jgarnierUQ/Homemade-Function-Generator/README.md

# Homemade-Function-Generator
The project that sparked my love of electronics! I made a function generator capable of generating sine, square, triangle, sawtooth, and reverse sawtooth waves up to 10kHz. It was part of a bigger device that also had a filter and power amplifier that all connected to each other.

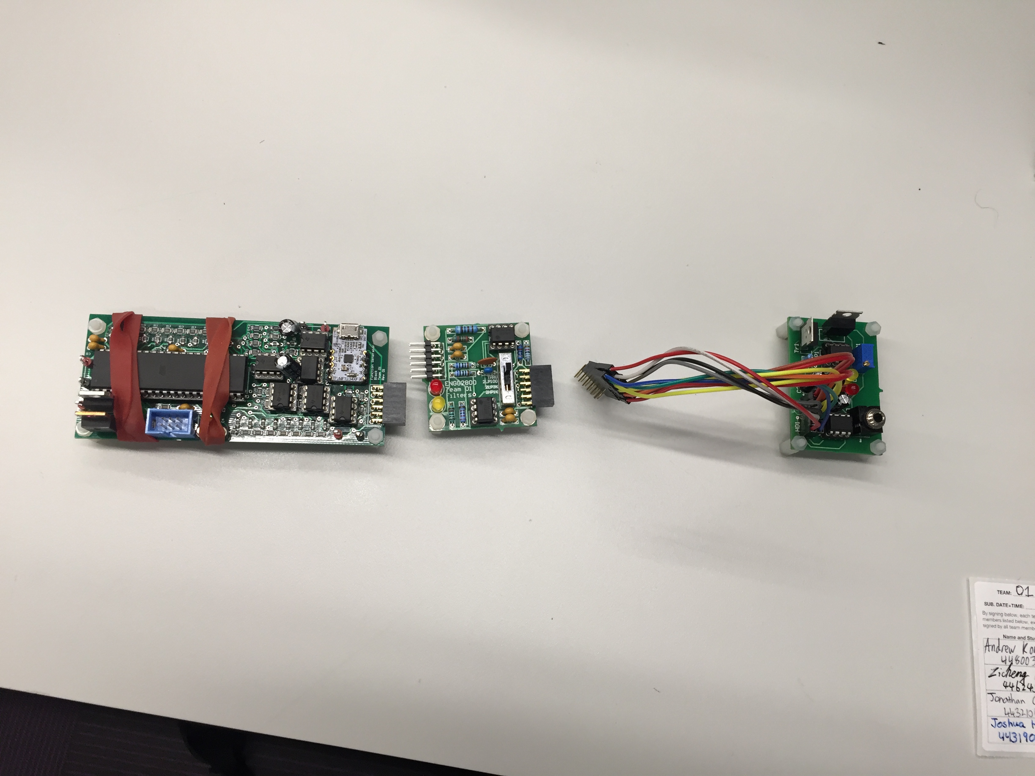
[picture p1: functionGenAllBlocks.JPG]


I was responsible for the function generator block, of which I designed all of the hardware and firmware.
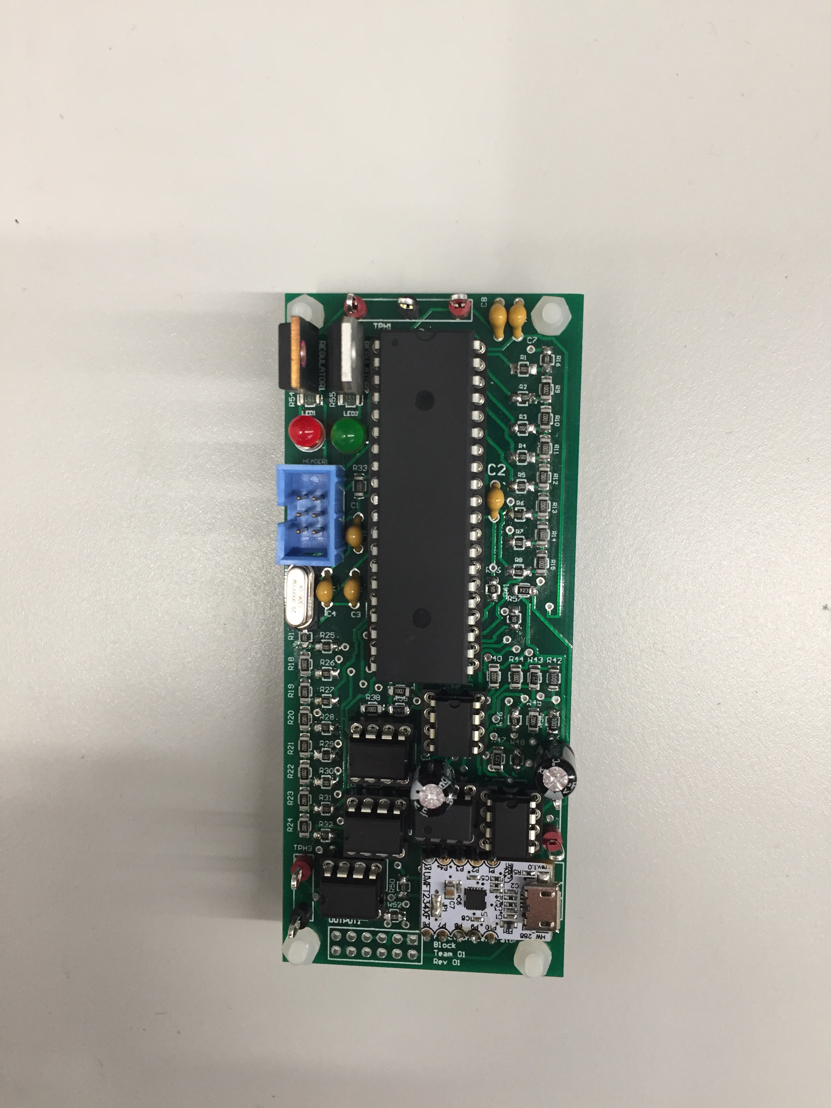
[picture p2: functionGen.JPG]


I utilised an Atmega324 for the processor as we were limited to 8-bit microcontrollers for this project. I was able to output the required waveforms by creating my own Digital to Analog Converters using resistor ladders, and then using look-up tables in firmware to control the waveforms.

This project was quite challenging but extremely rewarding once it was a working product. By far the most challenging aspect was the firmware, specifically being able to change the frequency of the waves. For this I implemented a phase accumulator (https://en.wikipedia.org/wiki/Numerically-controlled_oscillator), which caused a lot of headaches but got the job done! All of the code is available to view as well as my hardware schematics and Altium layouts.
