jgarnierUQ/Homemade-Function-Generator/Hardware/Function Generator Schematic.pdf

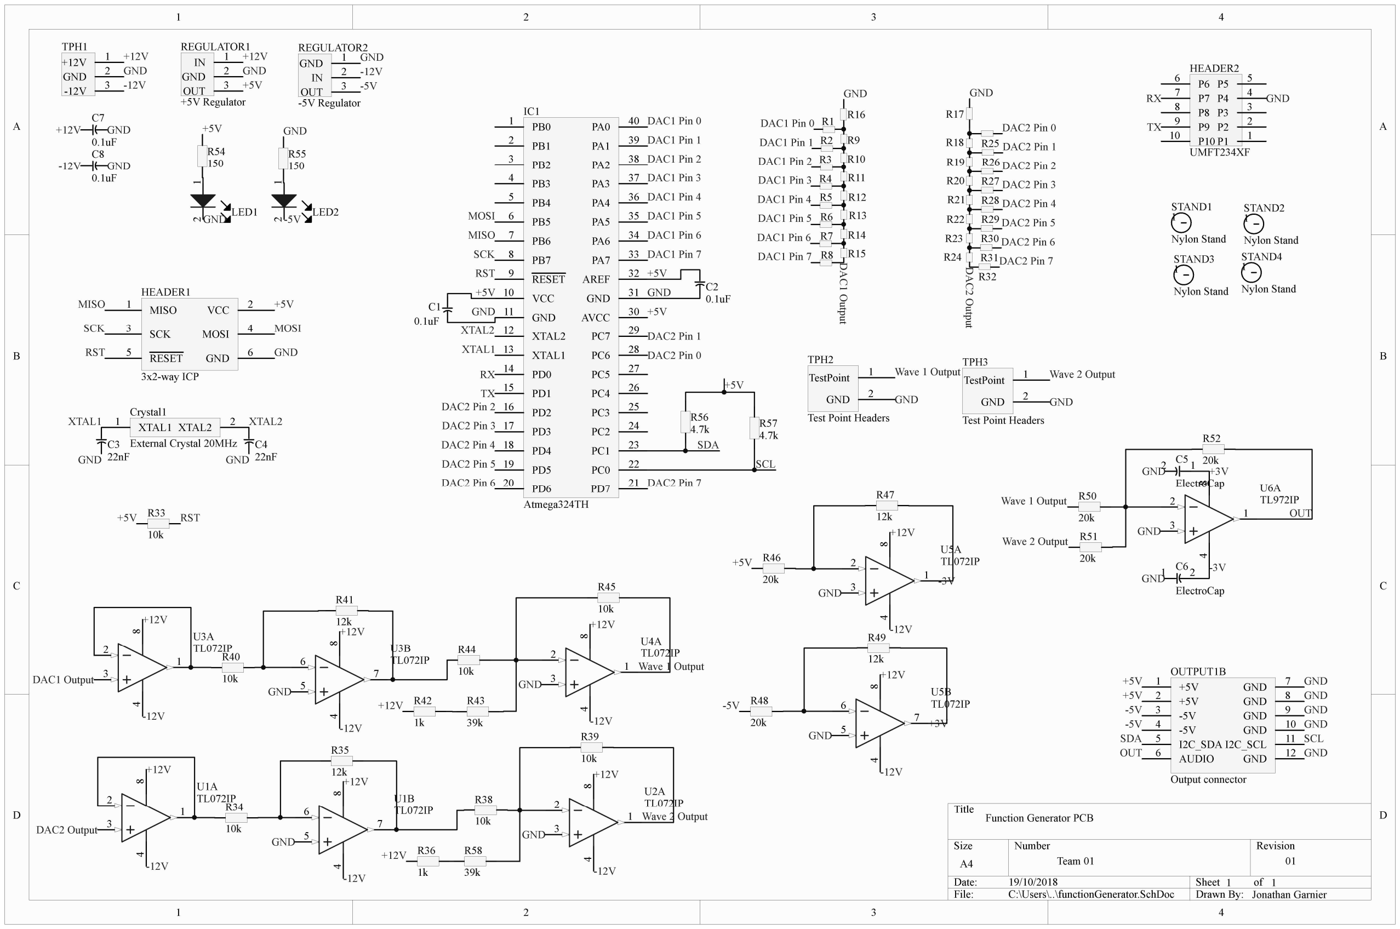
[picture p3: page 1]

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
Title

Size | Number | | Revision
A4
Date: | 19/10/2018 | Sheet | of
File: | C:\Users\..\functionGenerator.SchDoc | Drawn By:
+12V | 1
GND | 2
-12V | 3

TPH1
IN | 1
GND | 2
OUT | 3

REGULATOR1

+5V Regulator

GND | GND

PB0 1
PB1 2
PB2 3
PB3 4
PB4 5
PB5 6
PB6 7
PB7 8
RESET 9
VCC 10
GND 11
XTAL2 12
XTAL1 13
PD0 14
PD1 15
PD2 16
PD3 17
PD4 18
PD5 19
PD6 20 | PD7 | 21
| PC0 | 22
PC1 | 23
PC2 | 24
PC3 | 25
PC4 | 26
PC5 | 27
PC6 | 28
PC7 | 29
AVCC | 30
GND | 31
AREF | 32
PA7 | 33
PA6 | 34
PA5 | 35
PA4 | 36
PA3 | 37
PA2 | 38
PA1 | 39
PA0 | 40

IC1

Atmega324TH

+5V

+5V

+5V

+5V

GND
GND C1
0.1uF

C2
0.1uF

Function Generator PCB

Team 01 | 01
| Jonathan Garnier

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
DAC2 Pin 0
DAC2 Pin 1
DAC2 Pin 2
DAC2 Pin 3
DAC2 Pin 4
DAC2 Pin 5
DAC2 Pin 6
DAC2 Pin 7

DAC2 Pin 2
DAC2 Pin 3
DAC2 Pin 4
DAC2 Pin 5
DAC2 Pin 6 | DAC2 Pin 7

DAC1 Pin 0
DAC1 Pin 1
DAC1 Pin 2
DAC1 Pin 3
DAC1 Pin 4
DAC1 Pin 5
DAC1 Pin 6
DAC1 Pin 7

DAC1 Pin 0
DAC1 Pin 1
DAC1 Pin 2
DAC1 Pin 3
DAC1 Pin 4
DAC1 Pin 5
DAC1 Pin 6
DAC1 Pin 7

XTAL2 2 XTAL1 1

Crystal1

External Crystal 20MHz

XTAL1 | XTAL2

XTAL1

XTAL2

C3
22nF

C4
GND | GND 22nF

SCK

MISO

MOSI

RST

MISO 1 | VCC | 2
SCK 3 | MOSI | 4
RESET 5 | GND | 6

HEADER1

3x2-way ICP

+5V

GND

MOSI

MISO

SCK

RST

AUDIO 6

I2C_SDA 5

-5V 4

-5V 3

+5V 2

+5V 1 | GND | 7
| GND | 8
| GND | 9
| GND | 10
| I2C_SCL | 11
| GND | 12

OUTPUT1B

Output connector

+5V
+5V
GND | 1
IN | 2
OUT | 3

REGULATOR2

-5V Regulator

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
7 4 8 | U1B

### 1 TL072IP

2

3 | 4 8 | U1A TL072IP
+12V | +12V

-12V

-12V

-12V
-12V

+12V
+12V

GND

1

2

3 | 4 8 | U2A TL072IP

GND

+12V

-12V

R34

10k

R38

10k

R39

10k | DAC2 Output DAC1 Output

5

6

7 4 8 | U3B

### 1 TL072IP

2

3 | 4 8 | U3A TL072IP

-12V
-12V

+12V
+12V

GND

1

2

3 | 4 8 | U4A TL072IP

GND

+12V

-12V

R40

10k

R44

10k

R45

10k

DAC1 Output

DAC2 Output

1

2

3 | 4 8 | U6A TL972IP

1

2

3 | 4 8 | U5A TL072IP

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
+12V

-12V

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
7 4 8 | U5B
TL072IP

+12V

-12V

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
ElectroCap

1 2 C6

ElectroCap

GND

GND

C7

0.1uF
C8

0.1uF

GND

GND

+12V

-12V

R33

10k

P1 | 1
P2 | 2
P3 | 3
P4 | 4
P5 | 5 P6 6
P7 7
P8 8
P9 9
P10 10

HEADER2

UMFT234XF

GND

RX
TX

RX

TX

1

STAND1

Nylon Stand

1

STAND2

Nylon Stand

1

STAND3

Nylon Stand

1

STAND4

Nylon Stand

TestPoint | 1
GND | 2

TPH2

Test Point Headers

TestPoint | 1
GND | 2

TPH3

Test Point Headers

GND | GND

DAC2 Pin 1
DAC2 Pin 0

1 2

LED1 1 2

LED2 GND | -5V
SDA | SCL
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
4.7k | R57
| 4.7k

Wave 1 Output

Wave 2 Output

Wave 1 Output | Wave 2 Output
+5V | GND

RST

+12V

+12V

-5V

+5V

+5V

Wave 1 Output

Wave 2 Output
