jgarnierUQ/Homemade-Function-Generator/Hardware/BOM.xlsx

Designator | Component type | Value | Other notes | Quantity | Minimum order quantity | Cost each ($AUD) | Total price | Digikey # | Mouser # | RS # | E14 # | ETSG # | RoHS? | Datasheet URL
FUNCTION GENERATOR
R1 | Resistor, Surface Mount | 20k, 1% | 805 | 1 | 1 | 0.02 | 0.02 |  |  |  |  | 61-07-09 | Yes (See Distributer) | N/A
R2 | Resistor, Surface Mount | 20k, 1% | 805 | 1 | 1 | 0.02 | 0.02 |  |  |  |  | 61-07-10 | Yes (See Distributer) | N/A
R3 | Resistor, Surface Mount | 20k, 1% | 805 | 1 | 1 | 0.02 | 0.02 |  |  |  |  | 61-07-11 | Yes (See Distributer) | N/A
R4 | Resistor, Surface Mount | 20k, 1% | 805 | 1 | 1 | 0.02 | 0.02 |  |  |  |  | 61-07-12 | Yes (See Distributer) | N/A
R5 | Resistor, Surface Mount | 20k, 1% | 805 | 1 | 1 | 0.02 | 0.02 |  |  |  |  | 61-07-13 | Yes (See Distributer) | N/A
R6 | Resistor, Surface Mount | 20k, 1% | 805 | 1 | 1 | 0.02 | 0.02 |  |  |  |  | 61-07-14 | Yes (See Distributer) | N/A
R7 | Resistor, Surface Mount | 20k, 1% | 805 | 1 | 1 | 0.02 | 0.02 |  |  |  |  | 61-07-15 | Yes (See Distributer) | N/A
R8 | Resistor, Surface Mount | 20k, 1% | 805 | 1 | 1 | 0.02 | 0.02 |  |  |  |  | 61-07-16 | Yes (See Distributer) | N/A
R9 | Resistor, Surface Mount | 10k, 1% | 1206 | 1 | 1 | 0.01 | 0.01 |  |  |  |  | 63-04-05 | Yes (See Distributer) | N/A
R10 | Resistor, Surface Mount | 10k, 1% | 1206 | 1 | 1 | 0.01 | 0.01 |  |  |  |  | 63-04-06 | Yes (See Distributer) | N/A
R11 | Resistor, Surface Mount | 10k, 1% | 1206 | 1 | 1 | 0.01 | 0.01 |  |  |  |  | 63-04-07 | Yes (See Distributer) | N/A
R12 | Resistor, Surface Mount | 10k, 1% | 1206 | 1 | 1 | 0.01 | 0.01 |  |  |  |  | 63-04-08 | Yes (See Distributer) | N/A
R13 | Resistor, Surface Mount | 10k, 1% | 1206 | 1 | 1 | 0.01 | 0.01 |  |  |  |  | 63-04-09 | Yes (See Distributer) | N/A
R14 | Resistor, Surface Mount | 10k, 1% | 1206 | 1 | 1 | 0.01 | 0.01 |  |  |  |  | 63-04-10 | Yes (See Distributer) | N/A
R15 | Resistor, Surface Mount | 10k, 1% | 1206 | 1 | 1 | 0.01 | 0.01 |  |  |  |  | 63-04-11 | Yes (See Distributer) | N/A
R16 | Resistor, Surface Mount | 20k, 1% | 805 | 1 | 1 | 0.02 | 0.02 |  |  |  |  | 61-07-16 | Yes (See Distributer) | N/A
R17 | Resistor, Surface Mount | 20k, 1% | 805 | 1 | 1 | 0.02 | 0.02 |  |  |  |  | 61-07-17 | Yes (See Distributer) | N/A
R18 | Resistor, Surface Mount | 10k, 1% | 1206 | 1 | 1 | 0.01 | 0.01 |  |  |  |  | 63-04-11 | Yes (See Distributer) | N/A
R19 | Resistor, Surface Mount | 10k, 1% | 1206 | 1 | 1 | 0.01 | 0.01 |  |  |  |  | 63-04-12 | Yes (See Distributer) | N/A
R20 | Resistor, Surface Mount | 10k, 1% | 1206 | 1 | 1 | 0.01 | 0.01 |  |  |  |  | 63-04-13 | Yes (See Distributer) | N/A
R21 | Resistor, Surface Mount | 10k, 1% | 1206 | 1 | 1 | 0.01 | 0.01 |  |  |  |  | 63-04-14 | Yes (See Distributer) | N/A
R22 | Resistor, Surface Mount | 10k, 1% | 1206 | 1 | 1 | 0.01 | 0.01 |  |  |  |  | 63-04-15 | Yes (See Distributer) | N/A
R23 | Resistor, Surface Mount | 10k, 1% | 1206 | 1 | 1 | 0.01 | 0.01 |  |  |  |  | 63-04-16 | Yes (See Distributer) | N/A
R24 | Resistor, Surface Mount | 10k, 1% | 1206 | 1 | 1 | 0.01 | 0.01 |  |  |  |  | 63-04-17 | Yes (See Distributer) | N/A
R25 | Resistor, Surface Mount | 20k, 1% | 805 | 1 | 1 | 0.02 | 0.02 |  |  |  |  | 61-07-16 | Yes (See Distributer) | N/A
R26 | Resistor, Surface Mount | 20k, 1% | 805 | 1 | 1 | 0.02 | 0.02 |  |  |  |  | 61-07-17 | Yes (See Distributer) | N/A
R27 | Resistor, Surface Mount | 20k, 1% | 805 | 1 | 1 | 0.02 | 0.02 |  |  |  |  | 63-04-17 | Yes (See Distributer) | N/A
R28 | Resistor, Surface Mount | 20k, 1% | 805 | 1 | 1 | 0.02 | 0.02 |  |  |  |  | 63-04-18 | Yes (See Distributer) | N/A
R29 | Resistor, Surface Mount | 20k, 1% | 805 | 1 | 1 | 0.02 | 0.02 |  |  |  |  | 63-04-19 | Yes (See Distributer) | N/A
R30 | Resistor, Surface Mount | 20k, 1% | 805 | 1 | 1 | 0.02 | 0.02 |  |  |  |  | 63-04-20 | Yes (See Distributer) | N/A
R31 | Resistor, Surface Mount | 20k, 1% | 805 | 1 | 1 | 0.02 | 0.02 |  |  |  |  | 63-04-21 | Yes (See Distributer) | N/A
R32 | Resistor, Surface Mount | 20k, 1% | 805 | 1 | 1 | 0.02 | 0.02 |  |  |  |  | 63-04-22 | Yes (See Distributer) | N/A
R33 | Resistor, axial TH | 10k, 1% |  | 1 | 1 | 0.03 | 0.03 |  |  |  |  | 02-33-02 | Yes (See Distributer) | N/A
R34 | Resistor, axial TH | 10k, 1% |  | 1 | 1 | 0.03 | 0.03 |  |  |  |  | 02-33-03 | Yes (See Distributer) | N/A
R35 | Resistor, axial TH | 12k, 1% |  | 1 | 1 | 0.03 | 0.03 |  |  |  |  | 02-34-01 | Yes (See Distributer) | N/A
R36 | Resistor, axial TH | 1k, 1% |  | 1 | 1 | 0.03 | 0.03 |  |  |  |  | 02-25-02 | Yes (See Distributer) | N/A
R38 | Resistor, axial TH | 10k, 1% |  | 1 | 1 | 0.03 | 0.03 |  |  |  |  | 02-33-02 | Yes (See Distributer) | N/A
R39 | Resistor, axial TH | 10k, 1% |  | 1 | 1 | 0.03 | 0.03 |  |  |  |  | 02-33-03 | Yes (See Distributer) | N/A
R40 | Resistor, axial TH | 10k, 1% |  | 1 | 1 | 0.03 | 0.03 |  |  |  |  | 02-33-04 | Yes (See Distributer) | N/A
R41 | Resistor, axial TH | 12k, 1% |  | 1 | 1 | 0.03 | 0.03 |  |  |  |  | 02-34-01 | Yes (See Distributer) | N/A
R42 | Resistor, axial TH | 1k, 1% |  | 1 | 1 | 0.03 | 0.03 |  |  |  |  | 02-25-02 | Yes (See Distributer) | N/A
R43 | Resistor, axial TH | 39k, 1% |  | 1 | 1 | 0.03 | 0.03 |  |  |  |  | 02-38-01 | Yes (See Distributer) | N/A
R44 | Resistor, axial TH | 10k, 1% |  | 1 | 1 | 0.03 | 0.03 |  |  |  |  | 02-33-02 | Yes (See Distributer) | N/A
R45 | Resistor, axial TH | 10k, 1% |  | 1 | 1 | 0.03 | 0.03 |  |  |  |  | 02-33-03 | Yes (See Distributer) | N/A
R46 | Resistor, axial TH | 20k, 1% |  | 1 | 1 | 0.02 | 0.02 |  |  |  |  | 02-35-03 | Yes (See Distributer) | N/A
R47 | Resistor, axial TH | 12k, 1% |  | 1 | 1 | 0.03 | 0.03 |  |  |  |  | 02-34-01 | Yes (See Distributer) | N/A
R48 | Resistor, axial TH | 20k, 1% |  | 1 | 1 | 0.02 | 0.02 |  |  |  |  | 02-35-03 | Yes (See Distributer) | N/A
R49 | Resistor, axial TH | 12k, 1% |  | 1 | 1 | 0.03 | 0.03 |  |  |  |  | 02-34-01 | Yes (See Distributer) | N/A
R50 | Resistor, axial TH | 20k, 1% |  | 1 | 1 | 0.02 | 0.02 |  |  |  |  | 02-35-03 | Yes (See Distributer) | N/A
R51 | Resistor, axial TH | 20k, 1% |  | 1 | 1 | 0.02 | 0.02 |  |  |  |  | 02-35-04 | Yes (See Distributer) | N/A
R52 | Resistor, axial TH | 20k, 1% |  | 1 | 1 | 0.02 | 0.02 |  |  |  |  | 02-35-05 | Yes (See Distributer) | N/A
R54 | Resistor, axial TH | 150R, 1% |  | 1 | 1 | 0.13 | 0.13 |  |  |  |  | 02-18-02 | Yes (See Distributer) | N/A
R55 | Resistor, axial TH | 150R, 1% |  | 1 | 1 | 0.13 | 0.13 |  |  |  |  | 02-18-02 | Yes (See Distributer) | N/A
R56 | Resistor, axial TH | 4.7k, 1% |  | 1 | 1 | 0.06 | 0.06 |  |  |  |  | 2002-06-02 | Yes (See Distributer) | N/A
R57 | Resistor, axial TH | 4.7k, 1% |  | 1 | 1 | 0.06 | 0.06 |  |  |  |  | 2002-06-03 | Yes (See Distributer) | N/A
R58 | Resistor, axial TH | 39k, 1% |  | 1 | 1 | 0.03 | 0.03 |  |  |  |  | 02-38-01 | Yes (See Distributer) | N/A
C1 | Capacitor, Ceramic | 0.1uF |  | 1 | 1 | 0.04 | 0.29 |  |  |  |  | 03-26-01 | Yes (See Distributer) | N/A
C2 | Capacitor, Ceramic | 0.1uF |  | 1 | 1 | 0.04 | 0.29 |  |  |  |  | 03-26-02 | Yes (See Distributer) | N/A
C3 | Capacitor, Ceramic | 22nF |  | 1 | 1 | 0.04 | 0.04 |  |  |  |  | 2003-11-03 | Yes (See Distributer) | N/A
C4 | Capacitor, Ceramic | 22nF |  | 1 | 1 | 0.04 | 0.04 |  |  |  |  | 2003-11-03 | Yes (See Distributer) | N/A
C5 | Capacitor, Ceramic | 0.1uF |  | 1 | 1 | 0.04 | 0.29 |  |  |  |  | 03-26-01 | Yes (See Distributer) | N/A
C6 | Capacitor, Ceramic | 0.1uF |  | 1 | 1 | 0.04 | 0.29 |  |  |  |  | 03-26-02 | Yes (See Distributer) | N/A
C7 | Capacitor, Electrolytic | 100uF |  | 1 | 1 | 0.48 | 0.48 |  |  |  |  | 07-58-03 | Yes (See Distributer) | N/A
C8 | Capacitor, Electrolytic | 100uF |  | 1 | 1 | 0.48 | 0.48 |  |  |  |  | 07-58-03 | Yes (See Distributer) | N/A
REGULATOR1 | Voltage Regulator | 7805CV, 5V |  | 1 | 1 | 0.6 | 0.6 |  |  |  |  | 05-59-01 | Yes (See Distributer) | https://au.mouser.com/datasheet/2/389/l78-974043.pdf
REGULATOR2 | Voltage Regulator | LM7905, (-)5V |  | 1 | 1 | 0.69 | 0.69 |  |  |  |  | 05-60-01 | Yes (See Distributer) | http://www.hep.upenn.edu/SNO/daq/parts/lm7915.pdf
LED1 | LED, Standard, Diffused | Green |  | 1 | 1 | 0.16 | 0.16 |  |  |  |  | 04-50-01 | Yes (See Distributer) | N/A
LED2 | LED, Standard, Diffused | Red |  | 1 | 1 | 0.04 | 0.04 |  |  |  |  | 04-50-02 | Yes (See Distributer) | N/A
Crystal1 | Crystal / 20MHz / HC49/4HSMX Package | 20MHz |  | 1 | 1 | 0.54 | 0.54 |  |  |  |  | 04-95-01 | Yes (See Distributer) | https://www.iqdfrequencyproducts.com/products/details/hc49-4hsmx-17-31.pdf
U1 | Op Amp, Dual, Low Power | LM358 |  | 1 | 1 | 0.26 | 0.26 |  |  |  |  | 08-14-02 | Yes (See Distributer) | http://www.ti.com/lit/ds/symlink/lm158-n.pdf
U2 | Op Amp, Dual, Low Power | LM359 |  | 1 | 1 | 0.26 | 0.26 |  |  |  |  | 08-14-03 | Yes (See Distributer) | http://www.ti.com/lit/ds/symlink/lm158-n.pdf
U3 | Op Amp, Dual, Low Power | LM360 |  | 1 | 1 | 0.26 | 0.26 |  |  |  |  | 08-14-04 | Yes (See Distributer) | http://www.ti.com/lit/ds/symlink/lm158-n.pdf
U4 | Op Amp, Dual, Low Power | LM361 |  | 1 | 1 | 0.26 | 0.26 |  |  |  |  | 08-14-05 | Yes (See Distributer) | http://www.ti.com/lit/ds/symlink/lm158-n.pdf
U5 | Op Amp, Dual, Low Power | LM362 |  | 1 | 1 | 0.26 | 0.26 |  |  |  |  | 08-14-06 | Yes (See Distributer) | http://www.ti.com/lit/ds/symlink/lm158-n.pdf
U6 | General Purpose Amplifier 2 Circuit Rail-to-Rail 8-PDIP | TL972IP |  | 1 | 1 | 1.21 | 1.21 | 296-34316-5-ND |  |  |  |  | Yes (See Distributer) | http://www.ti.com/lit/ds/symlink/tl974.pdf
OUTPUT1B | Output Connector |  |  | 1 | 1 | 1.84 | 1.84 | S5559-ND |  |  |  |  | Yes (See Distributer) | https://drawings-pdf.s3.amazonaws.com/10494.pdf
HEADER2 | MOD USB BASIC UART DEV FT234XD | UMFT234XF |  | 1 | 1 | 8.99 | 8.99 | 768-1174-ND |  |  |  |  | Yes (See Distributer) | http://www.ftdichip.com/Support/Documents/DataSheets/Modules/DS_UMFT234XF.pdf
IC1 | 8 Bit Microcontroller, Low Power High Performance | ATMEGA324P |  | 1 | 1 | 4.86 | 4.86 |  |  |  |  | 07-14-03 | Yes (See Distributer) | http://ww1.microchip.com/downloads/en/DeviceDoc/ATmega324PV-AVR-MCU-with-CIP-and-picopower-40002102A.pdf
TPH | PCB Test Point / Raised Loop | Red |  | 4 | 1 | 0.16 | 0.64 |  |  |  |  | 01-95-01 | Yes (See Distributer) | N/A
TPH | PCB Test Point / Raised Loop | Black |  | 3 | 1 | 0.17 | 0.51 |  |  |  |  | 01-96-01 | Yes (See Distributer) | N/A
HEADER1 | CONNECTOR : PCB Boxed Header | 6 Way, 2 Row, 2.54mm Pitch |  | 1 | 1 | 2.61 | 2.61 |  |  |  |  | 01-77-01 | Yes (See Distributer) | N/A
STAND1 | Nylon Standoffs |  |  | 1 | 1 | 0.108 | 0.108 |  |  |  | D01492 |  | Yes (See Distributer) | http://www.farnell.com/datasheets/1685103.pdf
STAND2 | Nylon Standoffs |  |  | 1 | 1 | 0.108 | 0.108 |  |  |  | D01493 |  | Yes (See Distributer) | http://www.farnell.com/datasheets/1685103.pdf
STAND3 | Nylon Standoffs |  |  | 1 | 1 | 0.108 | 0.108 |  |  |  | D01494 |  | Yes (See Distributer) | http://www.farnell.com/datasheets/1685103.pdf
STAND4 | Nylon Standoffs |  |  | 1 | 1 | 0.108 | 0.108 |  |  |  | D01495 |  | Yes (See Distributer) | http://www.farnell.com/datasheets/1685103.pdf
 |  |  |  |  |  | TOTAL | 28.052
Filters
R1 | Resistor, axial TH | 18K, 1% |  | 1 | 1 | 0.03 | 0.03 |  |  |  |  | 02-35-02 | Yes (See Distributer) | N/A
R2 | Resistor, axial TH | 30K, 1% |  | 1 | 1 | 0.02 | 0.02 |  |  |  |  | 02-37-01 | Yes (See Distributer) | N/A
R3 | Resistor, axial TH | 9.1K, 1% |  | 1 | 1 | 0.03 | 0.03 |  |  |  |  | 02-33-01 | Yes (See Distributer) | N/A
R4 | Resistor, axial TH | 6.2K, 1% |  | 1 | 1 | 0.03 | 0.03 |  |  |  |  | 02-31-03 | Yes (See Distributer) | N/A
R5 | Resistor, axial TH | 11K, 1% |  | 1 | 1 | 0.02 | 0.02 |  |  |  |  | 02-33-03 | Yes (See Distributer) | N/A
R6 | Resistor, axial TH | 22K, 1% |  | 1 | 1 | 0.03 | 0.03 |  |  |  |  | 02-36-01 | Yes (See Distributer) | N/A
R7 | Resistor, axial TH | 600, 1% |  | 1 | 1 | 0.14 | 0.14 |  |  |  |  | 02-23-02 | Yes (See Distributer) | N/A
R8 | Resistor, axial TH | 600, 1% |  | 1 | 1 | 0.14 | 0.14 |  |  |  |  | 02-23-02 | Yes (See Distributer) | N/A
C1 | Capacitor, Ceramic TH | 0.1uF |  | 1 | 1 | 0.29 | 0.29 |  |  |  |  | 03-26-01 | Yes (See Distributer) | N/A
C2 | Capacitor, Ceramic TH | 0.047uF |  | 1 | 1 | 0.05 | 0.05 |  |  |  |  | 03-11-01 | Yes (See Distributer) | N/A
C3 | Capacitor, Ceramic TH | 0.01uF |  | 1 | 1 | 0.28 | 0.28 |  |  |  |  | 03-16-03 | Yes (See Distributer) | N/A
C4 | Capacitor, Ceramic TH | 0.0047uF |  | 1 | 1 | 0.12 | 0.12 |  |  |  |  | 03-07-01 | Yes (See Distributer) | N/A
C5 | Capacitor, Ceramic TH | 0.01uF |  | 1 | 1 | 0.28 | 0.28 |  |  |  |  | 03-16-03 | Yes (See Distributer) | N/A
C6 | Capacitor, Ceramic TH | 0.01uF |  | 1 | 1 | 0.28 | 0.28 |  |  |  |  | 03-16-03 | Yes (See Distributer) | N/A
D1 | LED, Yellow |  |  | 1 | 1 | 0.15 | 0.15 |  |  |  |  | 04-50-03 | Yes (See Distributer) | N/A
D2 | LED, Red |  |  | 1 | 1 | 0.04 | 0.04 |  |  |  |  | 04-50-02 | Yes (See Distributer) | N/A
SLB1470 | Switch |  |  | 1 | 1 | 2.34 | 2.34 |  |  |  |  | 16-32-01 | Yes (See Distributer) | http://www.farnell.com/datasheets/2609213.pdf
Input | Connector, Male TH |  |  | 1 | 1 | 0.98 | 0.98 |  |  |  |  | 609-3355-ND | Yes (See Distributer) | https://www.pcb-3d.com/wordpress/wp-content/uploads/FCI_68000_Serites_HDRV_1_Row_2-54mmP.pdf
Output | Connector, Female TH |  |  | 1 | 1 | 1.16 | 1.16 |  |  |  |  | S5559-ND | Yes (See Distributer) | https://drawings-pdf.s3.amazonaws.com/10494.pdf
OP1 | Op-amp, TL072CP |  |  | 1 | 1 | 0.54 | 0.54 |  |  |  |  | 08-01-01 | Yes (See Distributer) | http://www.ti.com/lit/ds/symlink/tl072.pdf
OP2 | Op-amp, TL072CP |  |  | 1 | 1 | 0.54 | 0.54 |  |  |  |  | 08-01-01 | Yes (See Distributer) | http://www.ti.com/lit/ds/symlink/tl072.pdf
N/A | Nylan Standoffs |  |  | 4 | 4 | 0.11 | 0.43 |  |  |  | D01495 |  | yes, https://au.element14.com/duratool/d01495/hex-threaded-spacer-nylon66-natural/dp/1733427 | http://www.farnell.com/datasheets/1685103.pdf?_ga=2.15585587.463211813.1539686043
 |  |  |  |  |  | TOTAL | 7.92
Power Amp
OP1 | TL0972IP OP AMP |  |  | 1 | 1 | 1.22 | 1.17 | 296-34316-5-ND |  |  |  |  | Yes https://www.digikey.com.au/product-detail/en/texas-instruments/TL972IP/296-34316-5-ND/1906129 | http://www.ti.com/lit/ds/symlink/tl971.pdf
Tr1 | TIP41C |  |  | 1 | 1 | 0.43 | 0.43 |  |  |  |  | 2001-03-05 | Yes (See Distributer) | https://www.st.com/resource/en/datasheet/tip41c.pdf
Tr2 | TIP42C |  |  | 1 | 1 | 0.44 | 0.44 |  |  |  |  | 05-48-03 | Yes (See Distributer) | https://www.st.com/resource/en/datasheet/tip41c.pdf
IC1 | Temp. Sensor DS1621+ |  |  | 1 | 1 | 5.68 | 5.68 | DS1621+-ND |  |  |  | 04-50-02 | Yes https://www.digikey.com.au/product-detail/en/maxim-integrated/DS1621/DS1621-ND/956905 | https://datasheets.maximintegrated.com/en/ds/DS1621.pdf
L2 | LED RED |  |  | 1 | 1 | 0.04 | 0.04 |  |  |  |  | 04-50-03 | Yes (See Distributer) | N/A
L1 | LED Orange |  |  | 1 | 1 | 0.16 | 0.16 |  |  |  |  | 07-58-03 | Yes (See Distributer) | N/A
C1,C2,C3 | Capacitor | 100uF |  | 3 | 1 | 0.48 | 1.44 |  |  |  |  | 2003-03-04 | Yes (See Distributer) | N/A
R1 | PCB potentiometer | 5k Ohm |  | 1 | 1 | 2.87 | 2.87 |  |  |  |  | 03-89-03 | Yes (See Distributer) | https://www.bourns.com/pdfs/3296.pdf
J1 | mono panel mount socket |  |  | 1 | 1 | 1.66 | 1.66 |  |  |  |  | 02-31-01 | Yes (See Distributer) | N/A
R2 | Resistor | 5.1k Ohm |  | 1 | 1 | 0.09 | 0.09 |  |  |  |  | 02-19-01 | Yes (See Distributer) | N/A
R3,R4 | Resistor | 180 Ohm |  | 2 | 1 | 0.13 | 0.26 |  |  |  |  |  | Yes (See Distributer) | N/A
N/A | Nylan Standoffs |  |  | 4 | 1 | 0.108 | 0.432 |  |  |  | D01495 |  | Yes https://au.element14.com/duratool/d01495/hex-threaded-spacer-nylon66-natural/dp/1733427 | http://www.farnell.com/datasheets/1685103.pdf
HD1 | Genblocks Header |  |  | 1 | 1 | 1.14 | 1.14 |  |  |  |  | 609-3355-ND | Yes (See Distributer) | https://cdn.amphenol-icc.com/media/wysiwyg/files/drawing/68020.pdf
 |  |  |  |  |  | TOTAL | 15.812
 |  |  |  |  |  | COMBINED TOTAL | 51.79
