jgarnierUQ/Homemade-Function-Generator/Hardware/bottom layer.pdf

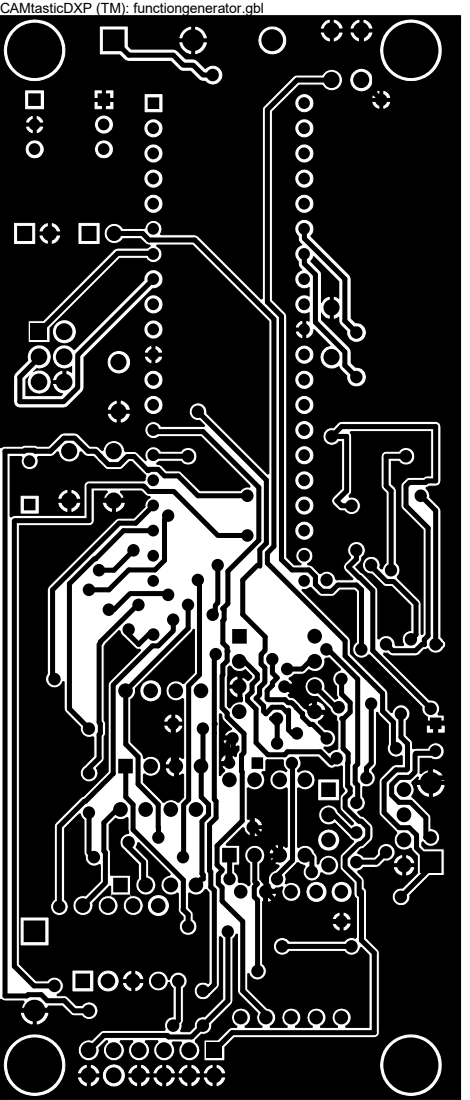
[picture p4: page 1]

CAMtasticDXP (TM): functiongenerator.gbl
