jgarnierUQ/Homemade-Function-Generator/Hardware/top layer.pdf

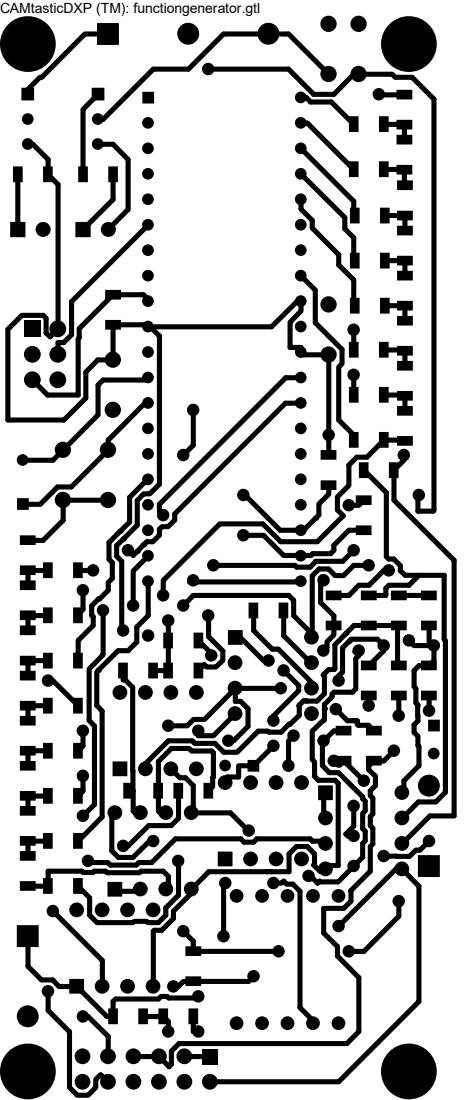
[picture p5: page 1]

CAMtasticDXP (TM): functiongenerator.gtl
