jgarnierUQ/Homemade-Function-Generator/Hardware/top overlay.pdf

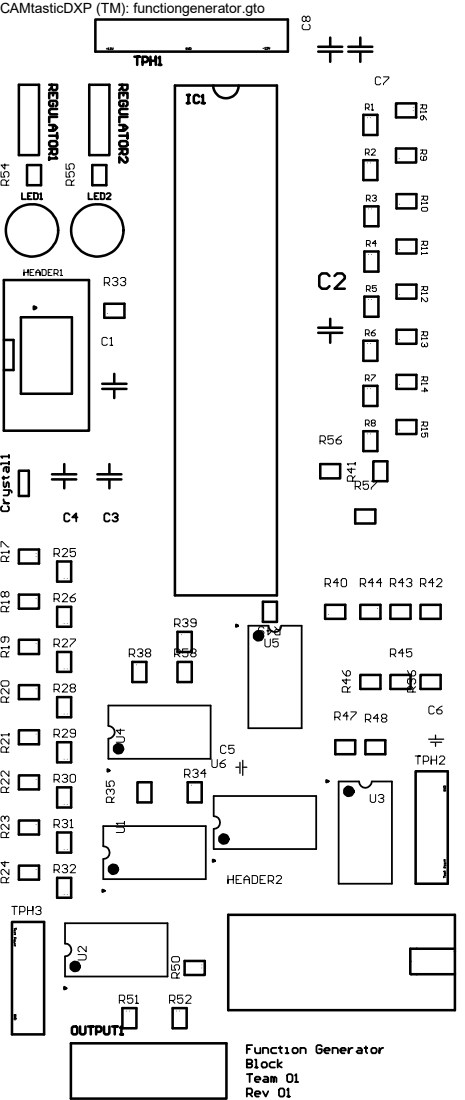
[picture p6: page 1]

CAMtasticDXP (TM): functiongenerator.gto
