jgarnierUQ/Homemade-Function-Generator/Firmware/waves.c

/*
 * waves.c
 *
 * Created: 2/09/2018 9:06:30 PM
 *  Author: jonga
 */ 

#include <avr/io.h>
#include <stdio.h>
#include <stdlib.h>
#include "waves.h"

//Wave 1
uint8_t waveOneType = SINE;
uint8_t waveOneAmplitude = 255;
uint8_t waveOneOffset = 128;
int waveOneFrequency = 1000;

//Wave 2
uint8_t waveTwoType = SINE;
uint8_t waveTwoAmplitude = 255;
uint8_t waveTwoOffset = 128;
int waveTwoFrequency = 1000;

//Arrays for storing values of the current waves outputs
uint8_t outputWave1[LUT_SIZE];
uint8_t outputWave2[LUT_SIZE];

//Phase accumulator stuff
uint32_t accumulator1;
uint32_t phase1;
uint32_t accumulator2;
uint32_t phase2;

//Sine lookup table
uint8_t sineLookup[LUT_SIZE] = {128,131,134,137,140,143,146,149,
	152,155,158,162,165,167,170,173,
	176,179,182,185,188,190,193,196,
	198,201,203,206,208,211,213,215,
	218,220,222,224,226,228,230,232,
	234,235,237,238,240,241,243,244,
	245,246,248,249,250,250,251,252,
	253,253,254,254,254,255,255,255,
	255,255,255,255,254,254,254,253,
	253,252,251,250,250,249,248,246,
	245,244,243,241,240,238,237,235,
	234,232,230,228,226,224,222,220,
	218,215,213,211,208,206,203,201,
	198,196,193,190,188,185,182,179,
	176,173,170,167,165,162,158,155,
	152,149,146,143,140,137,134,131,
	128,124,121,118,115,112,109,106,
	103,100,97,93,90,88,85,82,
	79,76,73,70,67,65,62,59,
	57,54,52,49,47,44,42,40,
	37,35,33,31,29,27,25,23,
	21,20,18,17,15,14,12,11,
	10,9,7,6,5,5,4,3,
	2,2,1,1,1,0,0,0,
	0,0,0,0,1,1,1,2,
	2,3,4,5,5,6,7,9,
	10,11,12,14,15,17,18,20,
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
	if (offset < 128) {
		scaledOffset = -1 * (128 - offset);
	} else {
		scaledOffset = offset - 128;
	}
	int byte;
	
	//Manipulate value of lookup table
	switch (type) {
		case SINE:
			output = (amplitude / 255.0) * sineLookup[index] + ((255.0 - amplitude) / 255.0) * 128.0 + scaledOffset;
			break;
			
		case TRIANGLE:
			output = (amplitude / 255.0) * triangleLookup[index] + ((255.0 - amplitude) / 255.0) * 128.0 + scaledOffset;
			break;
			
		case SAWTOOTH:
			output = (amplitude / 255.0) * sawToothLookup[index] + ((255.0 - amplitude) / 255.0) * 128.0 + scaledOffset;
			break;
			
		case REVERSE_SAWTOOTH:
			output = (amplitude / 255.0) * sawToothLookup[255 - index] + ((255.0 - amplitude) / 255.0) * 128.0 + scaledOffset;
			break;
			
		case SQUARE:
			output = (amplitude / 255.0) * squareLookup[index] + ((255.0 - amplitude) / 255.0) * 128.0 + scaledOffset;
			break;
	}
	return output;
}

/**
  * @brief  Updates the output lookup tables
  * @param  Desired amplitude, offset, frequency, which wave, and type of wave
  * @retval None
  */
void update_lookup_table(int amplitude, int offset, int frequency, int wave, int type) {
	int i;
	int prescalar;
	
	if (wave == WAVE_1) {
		for (i = 0; i < LUT_SIZE; i++) {
			outputWave1[i] = generate_wave(i, amplitude, offset, frequency, type);
		}
		
	} else if (wave == WAVE_2) {
		for (i = 0; i < LUT_SIZE; i++) {
			outputWave2[i] = generate_wave(i, amplitude, offset, frequency, type);
		}
	}
}

/**
  * @brief  Calculates the value of the phase. Should only be called once, not continually due to the function taking a long time.
  * @param  Desired frequency, which wave
  * @retval None
  */
void init_phase_accumulator(int frequency, int wave) {
	if (wave == WAVE_1) {
		accumulator1 = 0;
		phase1 = (uint32_t) ((frequency * 256. * 16777216.) / SAMPLE_RATE + 0.5);
	} else {
		accumulator2 = 0;
		phase2 = (uint32_t) ((frequency * 256. * 16777216.) / SAMPLE_RATE + 0.5);
	}
	
	
}
