jgarnierUQ/Homemade-Function-Generator/Firmware/timer.h

/*
 * timerFuncs.h
 *
 * Created: 18/08/2018 10:54:55 AM
 *  Author: jonga
 */ 

#include <avr/interrupt.h>

#ifndef TIMER_H_
#define TIMER_H_

void init_timer_0(void);
void init_timer_1(void);
void init_timer_2(void);





#endif /* TIMER_H_ */
